KrisUnderhill/TeamSediSensor/Documentation/ESP32/pinout_devkit_v4.png

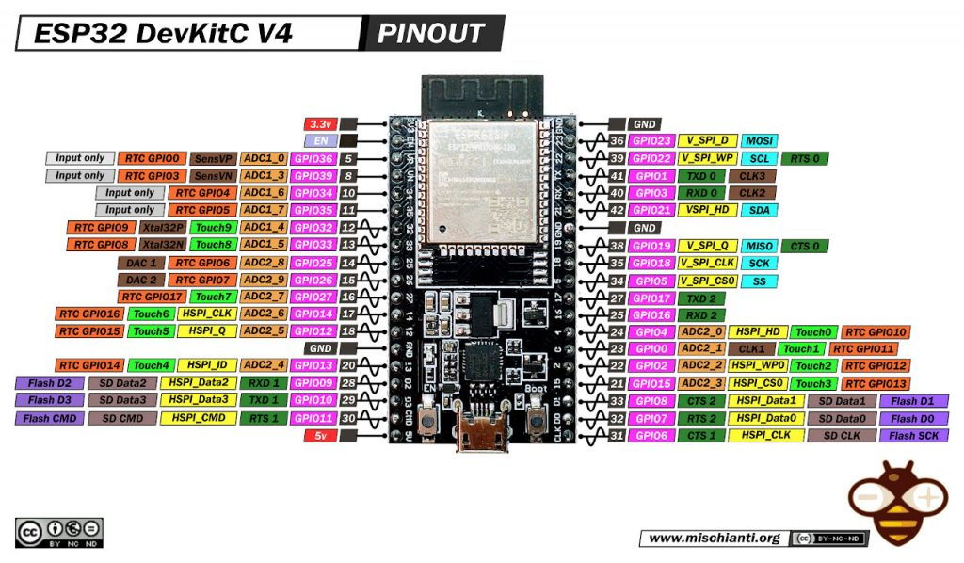
Documentation/ESP32/pinout_devkit_v4.png
