KrisUnderhill/TeamSediSensor/Documentation/BlockDiagram-Task Init.drawio.png

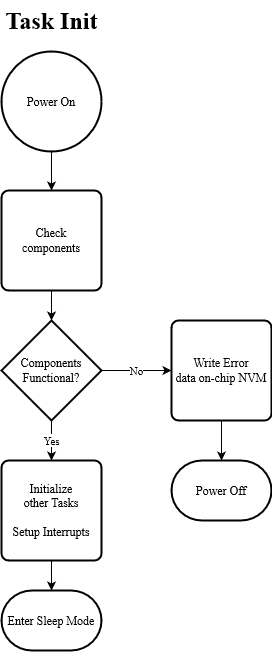
Documentation/BlockDiagram-Task Init.drawio.png
