KrisUnderhill/TeamSediSensor/Documentation/BlockDiagram-Task Transfer.drawio.png

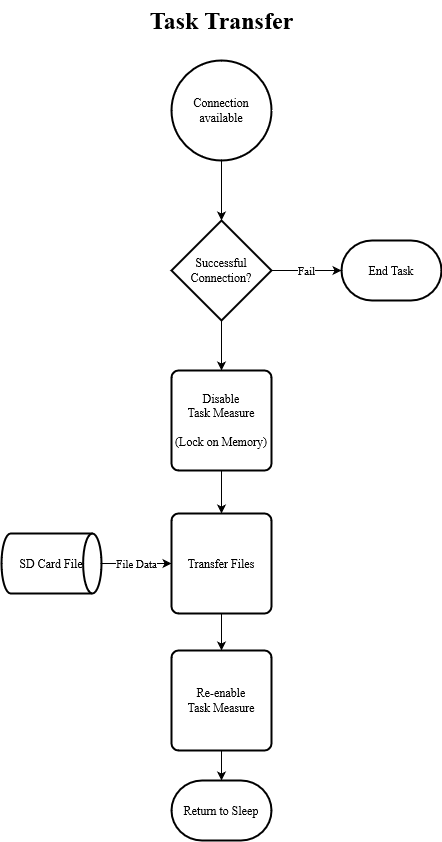
Documentation/BlockDiagram-Task Transfer.drawio.png
