KrisUnderhill/TeamSediSensor/Documentation/BlockDiagram-Task WiFi Horz.drawio.png

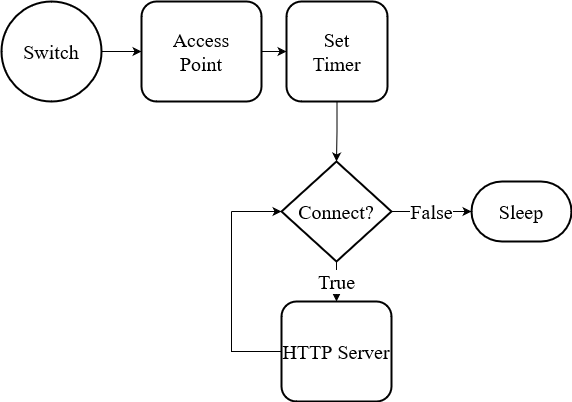
Documentation/BlockDiagram-Task WiFi Horz.drawio.png
