KrisUnderhill/TeamSediSensor/Documentation/BlockDiagram-Tasks Unified.drawio.png

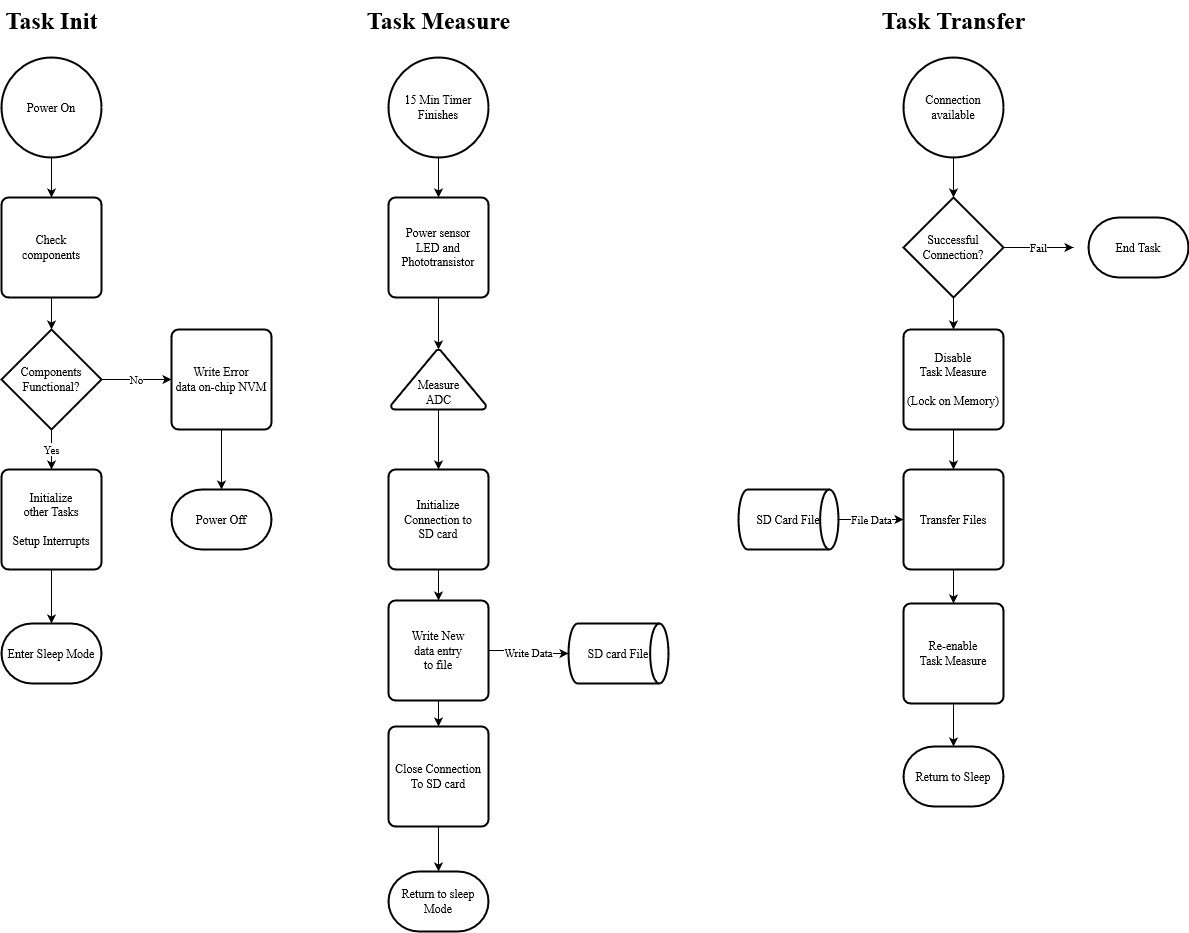
Documentation/BlockDiagram-Tasks Unified.drawio.png
