KrisUnderhill/TeamSediSensor/Documentation/Software/Fritzing_Schmatics/FinalPrototype_bb.png

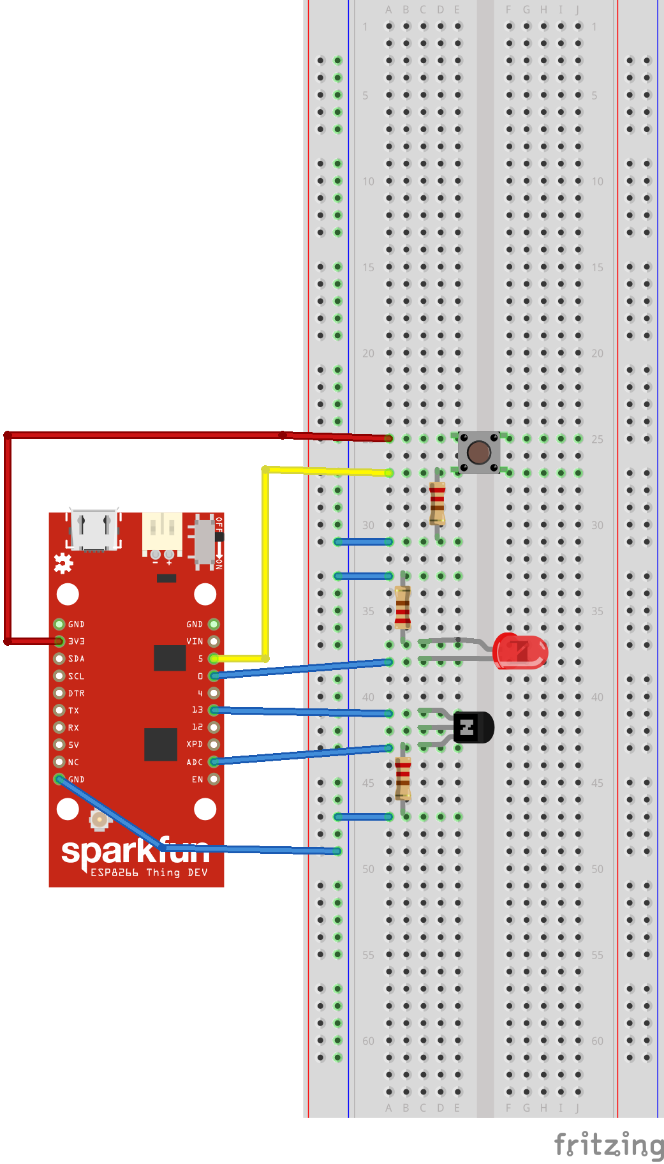
Documentation/Software/Fritzing_Schmatics/FinalPrototype_bb.png
