KrisUnderhill/TeamSediSensor/Documentation/Software/Fritzing_Schmatics/Initial_Prototype.png

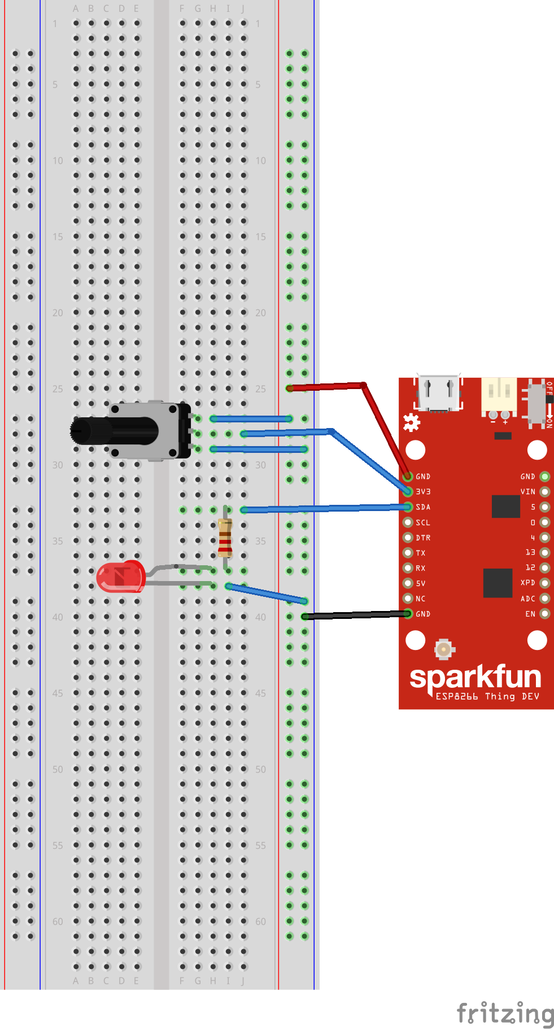
Documentation/Software/Fritzing_Schmatics/Initial_Prototype.png
