KrisUnderhill/TeamSediSensor/Documentation/Software/Fritzing_Schmatics/InitialPrototype.png

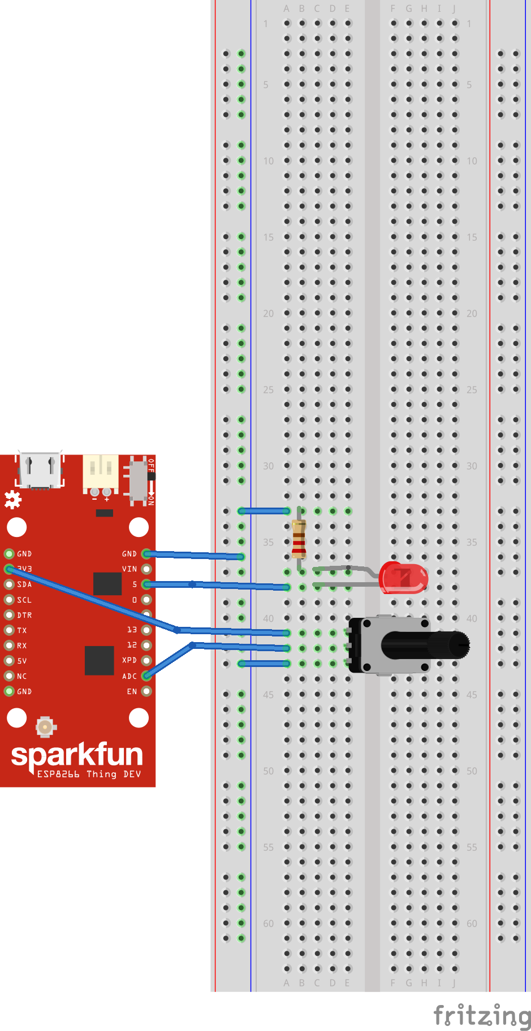
Documentation/Software/Fritzing_Schmatics/InitialPrototype.png
