KrisUnderhill/TeamSediSensor/Documentation/Software/Fritzing_Schmatics/TaskWifiPrototyp_bb.png

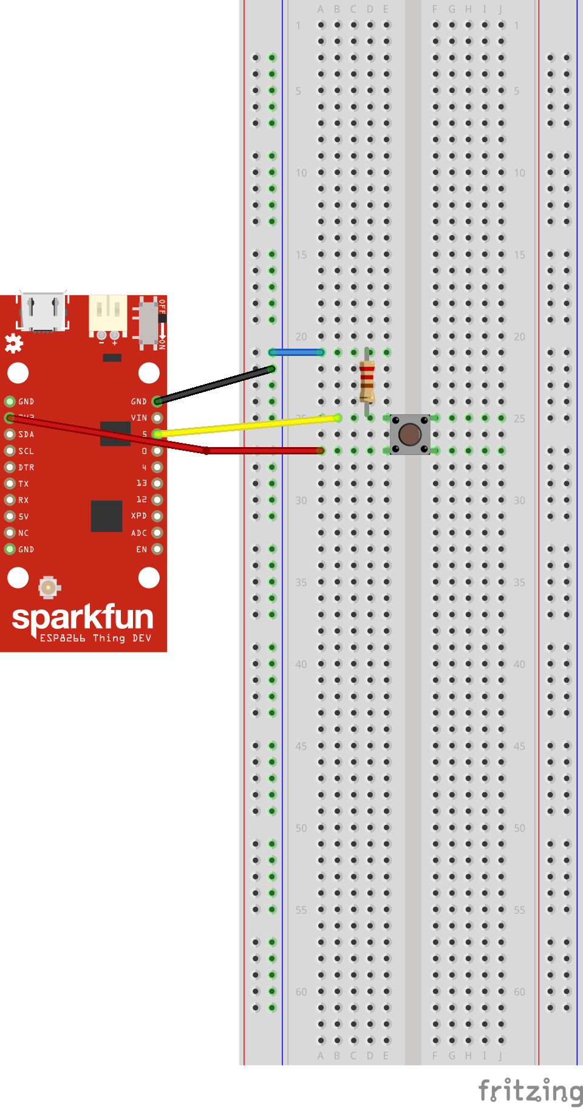
Documentation/Software/Fritzing_Schmatics/TaskWifiPrototyp_bb.png
