KrisUnderhill/TeamSediSensor/Specs/Proj_Specs_Team9.xlsx

ID | Outline | Type | Requirement | Comments | Reviewed | Next ID | 48
1 | 1 | HEADER | Sensor Design |  | TRUE
6 | 1.1 | HEADER | Accuracy |  | TRUE
17 | 1.1.1 | REQ | The sensor results shall, after calibration, match TSS data (mg/L) collected using grab sampling (traditional method) within 25% |  | TRUE
18 | 1.1.2 | REQ | The sensor results for repeated measurements on the same (Lab) sample shall match within 10% |  | TRUE
19 | 1.1.3 | REQ | The sensor results should provide a estimate for TSS data (in tons/yr) within 35% of data collected with stadia rod measurements (with estimates for soil density and characteristics and stream behavior upstream and downstream of sensor) | Prof. Wildschut measures with a different technique. Likely her method is less reliable but the measurements should line up | TRUE
7 | 1.2 | HEADER | Durability |  | TRUE
20 | 1.2.1 | REQ | The sensor should last 5 years, with regular maintenance. |  | TRUE
29 | 1.2.2 | REQ | The sensor shall perform with regular behavior for 3 months | Maintenance Interval | TRUE
30 | 1.2.3 | REQ | The sensor shall be resistant to environmental conditions |  | TRUE
31 | 1.2.4 | REQ | The sensor shall remain operable after a drop of 3 ft onto packed dirt |  | TRUE
8 | 1.3 | HEADER | Calibration |  | TRUE
21 | 1.3.1 | REQ | The sensor shall remain in calibration for 3 months. Defined as measurement after 3 months is within 10% of it’s original measurement. |  | TRUE
25 | 1.3.3 | REQ | The calibrated sensor shall have a maximum percent error of 15% |  | TRUE
22 | 1.3.4 | INFO | The sensor should be calibrated on lab samples with specified concentrations of suspended solids (Specifics of calibration procedure to be determined later) |  | TRUE
2 | 2 | HEADER | Mechanical Design |  | TRUE
9 | 2.1 | HEADER | Water Resistance |  | TRUE
23 | 2.1.1 | REQ | Sensing mechanism shall be submersible up to 5 ft of water depth |  | TRUE
26 | 2.1.2 | REQ | Sensing mechanism shall operate normally while submerged for up to 3 months |  | TRUE
32 | 2.2 | HEADER | Weather Resistant |  | TRUE
33 | 2.2.1 | REQ | The device construction should not degrade with Sunlight Exposure |  | TRUE
34 | 2.2.2 | REQ | The device shall operate during heavy rain events |  | TRUE
35 | 2.2.3 | REQ | The device shall operate regularly within the temperature range (-40°C, 85°C) |  | TRUE
36 | 2.2.4 | REQ | The device shall withstand minor snow events | Plan is for the device to be removed before/after snowfall | TRUE
10 | 2.3 | HEADER | Attachment to Streambed / Positioning |  | TRUE
27 | 2.3.1 | REQ | Device will attach to a typical rebar anchor | rebar anchor is existing infrastructure | TRUE
28 | 2.3.2 | REQ | Device attachment mechanism shall withstand flow rates of 200 cubic feet per minute |  | TRUE
45 | 2.4 | HEADER | Product Size |  | TRUE
46 | 2.4.1 | REQ | The Device shall weigh no more than 50 lbs. |  | TRUE
47 | 2.4.2 | REQ | The Device should be no larger than 2ft by 2ft by 2ft |  | TRUE
3 | 3 | HEADER | Electrical Hardware Design |  | TRUE
11 | 3.1 | HEADER | Power System |  | TRUE
37 | 3.1.1 | REQ | The device power system shall provide power for the system to operate normally for 3 months at a time without external charging |  | TRUE
38 | 3.1.2 | REQ | The system shall preserve locally stored data during a power loss event |  | TRUE
39 | 3.1.3 | REQ | The device should resume normal operation after power cycling |  | TRUE
12 | 3.2 | HEADER | Hardware Components |  | TRUE
44 | 3.2.1 | REQ | The Device shall be compliant with all FCC regulations |  | TRUE
4 | 4 | HEADER | Software Design |  | TRUE
13 | 4.1 | HEADER | Data Storage and Transmission |  | TRUE
40 | 4.1.1 | REQ | The software shall allow for intuitive and reliable access to data | *Access could mean user retrieves data in person, or data is transmitted to a server | TRUE
47 | 4.1.2 | REQ | The User should be able to see and set the device settings |  | TRUE
15 | 4.2 | HEADER | Active Behavior |  | TRUE
41 | 4.2.1 | REQ | The software shall reliably run the sensor |  | TRUE
42 | 4.2.2 | REQ | The software shall allow for reliable data collection |  | TRUE
43 | 4.2.3 | REQ | The software should recover from faults, transients |  | TRUE
