KrisUnderhill/TeamSediSensor/Software/prod/testResults/test_3_7_22.txt

Measuring with cap on about (with mirror):
2022-03-07 16:34:42, 0, 0.000, 2777, 2.645, 125, 11.9
2022-03-07 16:34:47, 0, 0.000, 2791, 2.658, 147, 14.0
2022-03-07 16:34:52, 0, 0.000, 2982, 2.840, 158, 15.0
2022-03-07 16:34:57, 0, 0.000, 1040, 0.990, 0, 0.0
2022-03-07 16:35:02, 0, 0.000, 64, 0.061, 0, 0.0
2022-03-07 16:35:07, 0, 0.000, 848, 0.808, 0, 0.0
2022-03-07 16:35:12, 0, 0.000, 1137, 1.083, 56, 5.3
2022-03-07 16:35:17, 0, 0.000, 2227, 2.121, 89, 8.5

without Mirror
2022-03-07 16:35:22, 0, 0.000, 0, 0.000, 0, 0.0

R_E transistor: 5.1K
LED current limiting: 330
