KrisUnderhill/TeamSediSensor/Software/prod/testResults/measure600mv.ods

#time | dark_ADC | dark_V | active_ADC | active_V
2022-01-31 15:18:38 | 656 | 0.529 | 654 | 0.527
2022-01-31 15:18:40 | 661 | 0.533 | 659 | 0.531
2022-01-31 15:18:42 | 664 | 0.535 | 656 | 0.529 | 630.083333333333
2022-01-31 15:18:44 | 657 | 0.529 | 643 | 0.518 | 625.5
2022-01-31 15:18:46 | 662 | 0.533 | 656 | 0.529 | 592
2022-01-31 15:18:48 | 643 | 0.518 | 656 | 0.529 | 26.4072026325621
2022-01-31 15:18:50 | 656 | 0.529 | 660 | 0.532
2022-01-31 15:18:52 | 643 | 0.518 | 647 | 0.521
2022-01-31 15:18:54 | 650 | 0.524 | 658 | 0.53 | -MEasure on the O-scope bouncing from abt 594 to 640 mv
2022-01-31 15:18:56 | 653 | 0.526 | 638 | 0.514
2022-01-31 15:18:58 | 644 | 0.519 | 654 | 0.527
2022-01-31 15:19:00 | 647 | 0.521 | 642 | 0.517
2022-01-31 15:19:02 | 637 | 0.513 | 628 | 0.506
2022-01-31 15:19:04 | 623 | 0.502 | 621 | 0.5
2022-01-31 15:19:06 | 613 | 0.494 | 624 | 0.503
2022-01-31 15:19:08 | 611 | 0.492 | 611 | 0.492
2022-01-31 15:19:10 | 614 | 0.495 | 624 | 0.503
2022-01-31 15:19:12 | 613 | 0.494 | 592 | 0.477
2022-01-31 15:19:14 | 610 | 0.492 | 607 | 0.489
2022-01-31 15:19:16 | 592 | 0.477 | 601 | 0.484
2022-01-31 15:19:18 | 597 | 0.481 | 592 | 0.477
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
