KrisUnderhill/TeamSediSensor/Software/prod/testResults/measure600mv_WithCap.ods

#time | dark_ADC | dark_V | active_ADC | active_V
2022-01-31 15:24:32 | 654 | 0.527 | 661 | 0.533
2022-01-31 15:24:34 | 642 | 0.517 | 655 | 0.528 | 638.552
2022-01-31 15:24:36 | 671 | 0.541 | 669 | 0.539 | 643
2022-01-31 15:24:38 | 672 | 0.542 | 685 | 0.552 | 624
2022-01-31 15:24:40 | 669 | 0.539 | 665 | 0.536 | 25.2508243238168
2022-01-31 15:24:42 | 663 | 0.534 | 662 | 0.533
2022-01-31 15:24:44 | 658 | 0.53 | 658 | 0.53
2022-01-31 15:24:46 | 671 | 0.541 | 673 | 0.542
2022-01-31 15:24:48 | 659 | 0.531 | 657 | 0.529
2022-01-31 15:24:50 | 650 | 0.524 | 656 | 0.529
2022-01-31 15:24:52 | 651 | 0.525 | 658 | 0.53
2022-01-31 15:24:54 | 647 | 0.521 | 649 | 0.523
2022-01-31 15:24:56 | 647 | 0.521 | 650 | 0.524
2022-01-31 15:24:58 | 643 | 0.518 | 651 | 0.525
2022-01-31 15:25:00 | 643 | 0.518 | 646 | 0.521
2022-01-31 15:25:02 | 643 | 0.518 | 638 | 0.514
2022-01-31 15:25:04 | 637 | 0.513 | 642 | 0.517
2022-01-31 15:25:06 | 640 | 0.516 | 641 | 0.517
2022-01-31 15:25:08 | 642 | 0.517 | 635 | 0.512
2022-01-31 15:25:10 | 649 | 0.523 | 638 | 0.514
2022-01-31 15:25:12 | 638 | 0.514 | 651 | 0.525
2022-01-31 15:25:14 | 645 | 0.52 | 647 | 0.521
2022-01-31 15:25:16 | 640 | 0.516 | 653 | 0.526
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
