KrisUnderhill/TeamSediSensor/Software/prod/testResults/4_6_22_afternoon_Outside.csv

#time | dark_ADC | dark_V | active_ADC | active_V | temp_ADC | temp_F | batt_ADC | batt_V | diff_ADC | diff_V
2022-04-04 18:16:47 | 9 | 0.007 | 56 | 0.045 | 784 | 63.2 | 3277 | 2.641 | 47 | 0.038
2022-04-04 18:16:48 | 4 | 0.003 | 54 | 0.044 | 784 | 63.2 | 3313 | 2.670 | 50 | 0.040
2022-04-04 18:16:49 | 203 | 0.164 | 389 | 0.313 | 784 | 63.2 | 3312 | 2.669 | 186 | 0.150
2022-04-04 18:16:50 | 177 | 0.143 | 305 | 0.246 | 782 | 63.0 | 3311 | 2.668 | 128 | 0.103
2022-04-04 18:16:51 | 150 | 0.121 | 272 | 0.219 | 782 | 63.0 | 3306 | 2.664 | 122 | 0.098
2022-04-04 18:16:52 | 208 | 0.168 | 321 | 0.259 | 783 | 63.1 | 2907 | 2.343 | 113 | 0.091
2022-04-04 18:16:53 | 49 | 0.039 | 176 | 0.142 | 780 | 62.9 | 3297 | 2.657 | 127 | 0.102
2022-04-04 18:16:54 | 55 | 0.044 | 76 | 0.061 | 782 | 63.0 | 3299 | 2.659 | 21 | 0.017
2022-04-04 18:16:55 | 0 | 0.000 | 421 | 0.339 | 784 | 63.2 | 3305 | 2.663 | 421 | 0.339
2022-04-04 18:16:56 | 0 | 0.000 | 361 | 0.291 | 784 | 63.2 | 3269 | 2.634 | 361 | 0.291
2022-04-04 18:16:57 | 75 | 0.060 | 202 | 0.163 | 783 | 63.1 | 3294 | 2.655 | 127 | 0.102
2022-04-04 18:16:58 | 85 | 0.068 | 176 | 0.142 | 782 | 63.0 | 3294 | 2.655 | 91 | 0.073
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
