KrisUnderhill/TeamSediSensor/Software/prod/testResults/SemPondTest_4_8_22.csv

#time | dark_ADC | dark_V | active_ADC | active_V | temp_ADC | temp_F | batt_ADC | batt_V | diff_ADC | diff_V | NTU
2022-04-06 16:42:54 | 0 | 0.000 | 1615 | 1.301 | 835 | 67.3 | 4095 | 3.300 | 1615 | 1.301 | 1408.190
2022-04-06 16:43:09 | 0 | 0.000 | 0 | 0.000 | 834 | 67.2 | 4095 | 3.300 | 0 | 0.000 | 34.306 | *
2022-04-06 16:43:24 | 0 | 0.000 | 0 | 0.000 | 834 | 67.2 | 4095 | 3.300 | 0 | 0.000 | 34.306 | *
2022-04-06 16:43:37 | 0 | 0.000 | 0 | 0.000 | 830 | 66.9 | 4095 | 3.300 | 0 | 0.000 | 34.306 | *
2022-04-06 16:43:52 | 0 | 0.000 | 0 | 0.000 | 829 | 66.8 | 4076 | 3.285 | 0 | 0.000 | 34.306 | *
2022-04-06 16:44:07 | 0 | 0.000 | 0 | 0.000 | 836 | 67.4 | 4084 | 3.291 | 0 | 0.000 | 34.306 | *
2022-04-06 16:44:22 | 0 | 0.000 | 0 | 0.000 | 832 | 67.0 | 4095 | 3.300 | 0 | 0.000 | 34.306 | *
2022-04-06 16:44:37 | 0 | 0.000 | 0 | 0.000 | 833 | 67.1 | 4080 | 3.288 | 0 | 0.000 | 34.306 | *
2022-04-06 16:44:52 | 0 | 0.000 | 0 | 0.000 | 833 | 67.1 | 4095 | 3.300 | 0 | 0.000 | 34.306 | *
2022-04-06 16:45:07 | 0 | 0.000 | 0 | 0.000 | 833 | 67.1 | 4052 | 3.265 | 0 | 0.000 | 34.306 | *
2022-04-06 16:45:22 | 0 | 0.000 | 0 | 0.000 | 837 | 67.5 | 4065 | 3.276 | 0 | 0.000 | 34.306 | *
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
