KrisUnderhill/TeamSediSensor/Documentation/BlockDiagram-Task Measure Horz.drawio.png

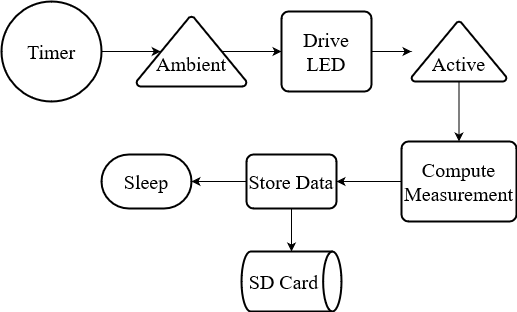
Documentation/BlockDiagram-Task Measure Horz.drawio.png
