KrisUnderhill/TeamSediSensor/Documentation/BlockDiagram-Task Measure.drawio.png

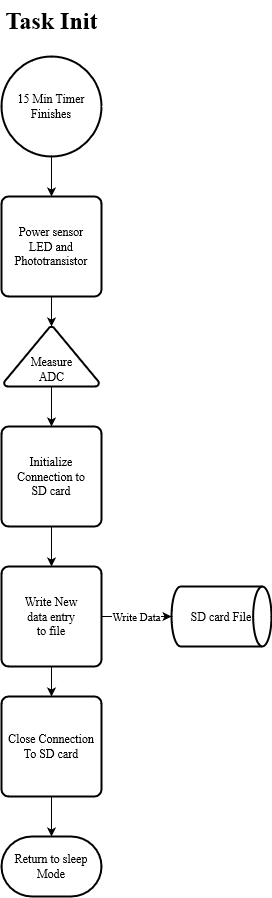
Documentation/BlockDiagram-Task Measure.drawio.png
