KrisUnderhill/TeamSediSensor/Documentation/Software/Fritzing_Schmatics/TaskMeasurePrototype.png

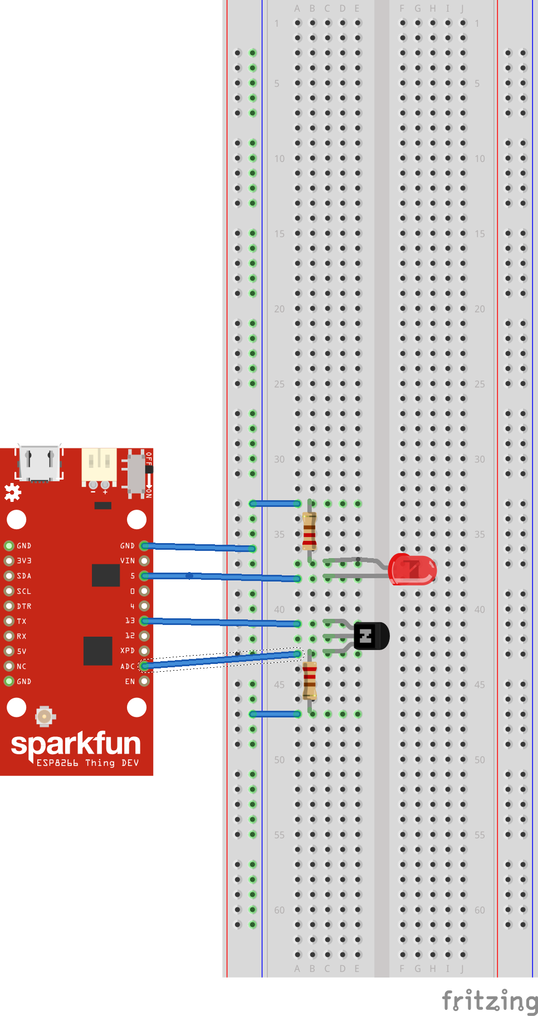
Documentation/Software/Fritzing_Schmatics/TaskMeasurePrototype.png
