KrisUnderhill/TeamSediSensor/Software/prod/testResults/WiFi_Signal_Strength_5m.png

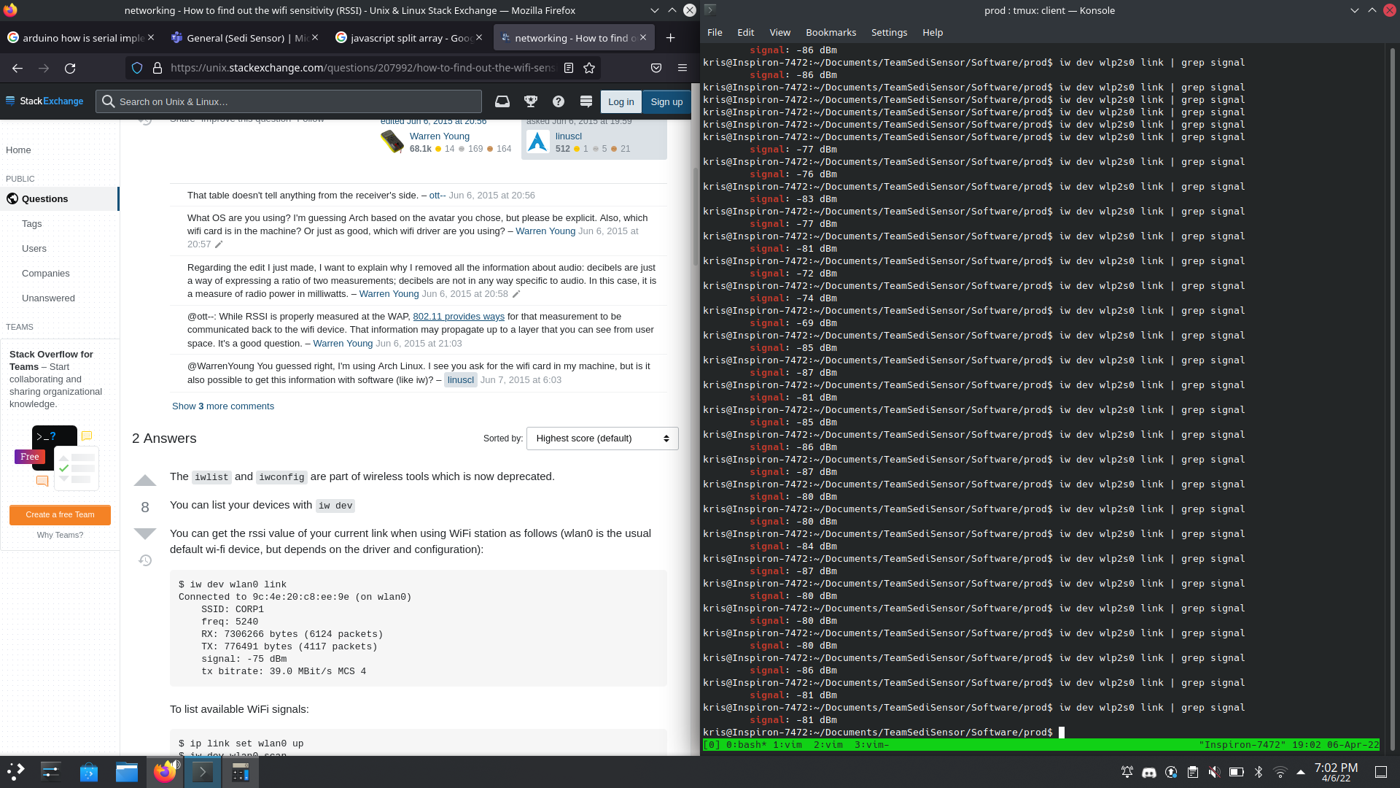
Software/prod/testResults/WiFi_Signal_Strength_5m.png
