KrisUnderhill/TeamSediSensor/(threads)

Thread 7 (2021-10-13):

Oral Presentation 2

KrisUnderhill, 2021-10-13:
### Pre-presentation
• This presentation will be to your faculty advisor and the other teams that he or she advises.
• Develop a presentation meeting the requirements below.  Your presentation should be audible,
clear, informative, and persuasive.
• The presentation complements the more-detailed PPFS and should give the advisor confidence that based on current progress, the project will finish successfully by the end of the second semester, including technical aspects along with cost and timing.
### Presentation Content
Your presentation should be approximately 10 minutes long.  Your grade may be affected if your presentation is significantly longer or shorter than that time.
Your title slide should clearly identify your team number and name and have pictures of each team member with names and concentrations.
Then reintroduce your project – briefly tell us again what problem you are trying to solve.  Most of your presentation should focus on the feasibility of your project and your status.
**Your presentation must cover:**
• What problem are you solving or what are you trying to accomplish?
• Who is/are your customer(s)?
• What are your constraints? Requirements? Objectives?
• What constitutes success at the end of the year? How will you know if you have met your goals?
• What are your design options?
• What evidence do you have to support feasibility?
• How do you evaluate your status relative to your overall timing?  **Your presentation _may_ cover:**
• What important resources have you obtained (or at least identified)?
• What engineering analysis have you done, and what did you learn from it?
• Has anything changed or is there an update on Christian motivation, virtues, or design norms?
• What major obstacles/issues have you overcome?
• What major obstacles/issues remain?
• What major decisions have you made so far? What major accomplishments can you report?
• Has anything significant changed since your first report?

Polish your presentation by making sure there are no spelling errors or grammar mistakes. Add photos of work in progress, CAD drawings, maps, mock-ups of your product, or other visuals to enhance the
presentation.

### Grading
Only one or two members of the team give the presentation, but the grade is assigned to the entire team.
An excellent presentation will:
• Stick to the time limit
• Have high-quality visual aids
• Be clear and audible
• Effectively cover the content as described above.

Thread 15 (2022-01-05):

run gpio commands based off esp32 timers

KrisUnderhill, 2022-01-05:
use timers instead of delay

KrisUnderhill, 2022-01-07:
Will need to decide how this interfaces with sleep modes, ble tasks etc.

Closed 2022-01-07.

Thread 16 (2022-01-05):

Fix Build cmd

KrisUnderhill, 2022-01-05:
Build command says bin is up to date after build command fails
fix
possiblities: base command off if binary exits not if directory is empty

KrisUnderhill, 2022-01-06:
Pt 2 find a way to only flash with app:esp32flash when build was successful

KrisUnderhill, 2022-01-06:
Fixed part 2 wont fix part 1
Reasoning: currently will have to rebuilt every time because time in config.h will have to change every build

Closed 2022-01-06.

Thread 17 (2022-01-05):

Verify cross platform compatibility for copyLib on windows

KrisUnderhill, 2022-01-05:

KrisUnderhill, 2022-03-08:
Currently can build, skips generating web files again so looking to fix that later

Thread 21 (2022-01-06):

Time Discussion

KrisUnderhill, 2022-01-06:
1) Timezones suck - discuss only using utc (Otherwise find way to generate timezone at build time)
2) Currently using build time as proxy for flash time / time after reset (ie so time will be off significantly if flashed after build or reset during operation) Otherwise find a way to reset time after the fact via BT or WIFI.
3) Abstract time into PS_Time lib

KrisUnderhill, 2022-01-13:
Decision to use Build time and expose BLE api for configuring time

Thread 23 (2022-01-06):

Fix Include paths for written libs

KrisUnderhill, 2022-01-06:
Currently include a user written lib by "../<LIB_NAME>/<FILE_NAME>.h
fix include path included automatically with "<FILE_NAME>.h"

Thread 36 (2022-01-27):

Improve HW control of sensor

KrisUnderhill, 2022-01-27:
Sensor will need to measure dark current, turn light on, measure current, calculate voltage, and turn off light

Closed 2022-01-28.

Thread 39 (2022-01-28):

Prevent multiple initializations of Singleton classes

KrisUnderhill, 2022-01-28:

KrisUnderhill, 2022-03-09:
Decided this is the job of the developer not to screw this up

Closed 2022-03-09.

Thread 46 (2022-02-09):

Power the SD Card module

KrisUnderhill, 2022-02-09:
SD Card module can now only be powered from 5v once hardware improves
power it from the 3.3 v pin

Thread 47 (2022-02-09):

Power the Temp Sensor, convert to C

KrisUnderhill, 2022-02-09:
Current temp sensor is powered from 5 volts and gives temp in F,
buy a temp sensor that can be powered from 3.3 V and gives temp in C

KrisUnderhill, 2022-03-08:
Plan is to power the temp sensor constant from 5-6.3 v, read with adc, so won't change temp sensor for now

Closed 2022-03-08.

Thread 59 (2022-02-18):

Implement FileSystem class

KrisUnderhill, 2022-02-18:
PS_SDFile doesn't work well
Need to implement class that
1) returns file ptr or class (open Method)
2) track which tasks have locks on which files
3) verify filesystem on init

Closed 2022-02-19.

Thread 60 (2022-02-18):

Debounce buttons

KrisUnderhill, 2022-02-18:
Button may currently run interrupt when not pressed bc of lacking debouncing
I don't feel like fixing this rn because as of now I have no idea what the final button looks like

Thread 68 (2022-02-20):

Decide how to measure task delays

KrisUnderhill, 2022-02-20:
1) use software/hw timer
     - possibly easier to go into light sleep during
2) Use calls to millis() and calculate against last time
      -simpler

KrisUnderhill, 2022-02-20:
#45 is similar

KrisUnderhill, 2022-03-07:
Fix #58 at the same time

KrisUnderhill, 2022-03-07:
Didn't mean to close

Thread 69 (2022-02-20):

Use a true semaphore and block when try to access locked files

KrisUnderhill, 2022-02-20:
Currently locking is supported but the calls to open() if they fail the process continues straight on
Make sure that if it continues it has the file by either blocking or looping through again to request the file

KrisUnderhill, 2022-03-07:
Not necessary until true multithreading #63

Thread 72 (2022-02-25):

Setup Watchdog Timers

KrisUnderhill, 2022-02-25:
Timers should be able to fire if wifi task or measure task fails and reset the system

Thread 78 (2022-03-09):

Bug: wifi not recognizing disconnect

KrisUnderhill, 2022-03-09:
disconnected from wifi (setup so it should shut off after so long when no devices viconnected)
When laptop disconnected from wifi it took a while for the esp to recognize that no devices were connected (like 40 sec) It just returned num connected as 0 when I had reconnected and disconnected again (the second time it worked properly)
