KrisUnderhill/TeamSediSensor/Electronics/Simulation/HighPass_RailtoRail/Draft1.asc

C1: cap; 0.15µF
C2: cap; 0.15µ
C3: cap; 0.1µ
Q2: npn
R1: res; 100k
R2: res; 10k
R3: res; 10k
R4: res; 100k
R5: res; 10k
R6: res; 10k
U1: OP07
U2: LT1490A
V1: voltage; 1v
V2: voltage; PULSE(0 100m 0 0.1n 0.1n 0.5m 1m)
V3: voltage; 3.3
Named nets: 0, Vcc
.tran 50m
