KrisUnderhill/TeamSediSensor/Electronics/Simulation/Physical_Circuit_models/Circuit_Models.asc

Q1: npn
R1: res; 91K
R2: res; 10k
R3: res; 10k
R4: res; 1k
U1: LT1001
V1: voltage; 5
V2: voltage; 5
Vsrc: voltage; 5
Vtest: voltage; 0.05
Named nets: Vcc, 0, -Vcc, Vout, Vsrc
.dc Vsrc 0 5 0.01
