KrisUnderhill/TeamSediSensor/Electronics/Simulation/ADC/test_ADC.asc

Bsclk: bv; V=max(V(sclk1),V(sclk2))
C1: cap; 10p
C2: cap; 10µ; ic=4.096; Rser=10m
C3: cap; 1n
C4: cap; 10µ; ic=1.25
D1: diode
I1: current; 2n
I2: current; 2n
Q1: npn
Q2: npn
R1: res; 330K
R2: res; 330K
U1: LTC2311-12
U2: AD8032
V1: voltage; PULSE(0 1.8 227n .1n .1n 40n 199.5n)
V2: voltage; PWL(0 0 0.1u 5)
V3: voltage; 1.8
V4: voltage; 5
V5: voltage; -5
Va-: voltage; 0
Vsclk1: voltage; PULSE(0 1.8 9.5n .1n .1n 4.65n 9.5n)
Vsclk2: voltage; PULSE(0 1.81 11.875n .1n .1n 66.5n 199.5n)
Vtest2: voltage; SINE(1 1 50k)
Vtest: voltage; 60m
Named nets: 0, OUT, sclk2, sclk1, Vcc, Vsens, Vtest, VopAmp, Vtest2, -Vcc, Vsens_base
.tran 20u
SCLK and _CNV
are shown in timing
diagram on page 11
of LTC2311-12 data sheet
Maximum admissible current draw 50 mA
Shoot for Max current of 5 mA?
ADC Circuit
Sensor Circuit
TSS
Electronics Simulation
Amplifier
