KrisUnderhill/TeamSediSensor/Electronics/Simulation/Phototransistor/test_PhotoTransistor.asc

-Vcc: voltage; 5v
Itest1: current; 20n
Q1: npn
R1: res; 330K
Vcc: voltage; 5
Vtest2: voltage; SINE(2.5 5 1k)
Vtest: voltage; 100m
Named nets: Vcc, -Vcc, 0, Vtest, Vtest2
.op
