KrisUnderhill/TeamSediSensor/Electronics/Simulation/Rail-to-Rail/test_RROpAmp.asc

-Vcc: voltage; 5v
U1: AD8031
Vcc: voltage; 5
Vtest2: voltage; SINE(2.5 5 1k)
Vtest: voltage; 100m
Named nets: Vcc, -Vcc, 0, Vtest, Vtest2, VopAmp
.tran 1m
