KrisUnderhill/TeamSediSensor/Electronics/Simulation/TransAmpedance/test_TransAmpedanceAmplifier.asc

-Vcc: voltage; 5
Itest1: current; 2n
Itest2: current; 2n
Itest3: current; 2n
Itest4: current; 2n
Q1: npn
Q2: npn
Q3: npn
Q4: npn
Q5: npn
R1: res; 1Meg
R2: res; 500k
R5: res; 330k
R6: res; 10k
U1: AD8031
U2: AD8031
U3: LT1001
V1: voltage; 0.5
V2: voltage; 4
Vcc: voltage; 5
Vtest2: voltage; SINE(2.5 5 1k)
Vtest: voltage; 100m
Named nets: Vcc, -Vcc, 0, Vtest, Vtest2, VopAmp, VopAmp2, VopAmp3
.dc Itest4 0 20n  0.01n
