KrisUnderhill/TeamSediSensor/(list of files, drawings)

Other design files:
Documentation/Software/Fritzing_Schmatics/DevelopmentPrototype.fzz
Documentation/Software/Fritzing_Schmatics/FinalPrototype.fzz
Documentation/Software/Fritzing_Schmatics/InitialPrototype.fzz
Documentation/Software/Fritzing_Schmatics/TaskWifiPrototyp.fzz
