KrisUnderhill/TeamSediSensor/(commit log)

2021-10-12 Initial writing of specs/req doc
    [Proj_Specs_Team9.csv, Proj_Specs_Team9.xlsx]
2022-01-02 Started project Rakefile
    for test_WIFIexample project
    basic functionality: build, clean
    built on top of arduino CLI calls
2022-01-06 Add Timestamp
    rakefile: autogenerates config.h lib with build time (off by about a
    minute from actual laptop time
    Task_Measure: setup time (Hardcoded Eastern), and prints
2022-01-06 app:esp32flash does not execute if build failed
2022-01-07 HW timers
    Task_Measure runs on a timer configured to trigger every 15s
2022-01-11 Started python tools
    Used for interacting with the ESP32 through linux system drivers
2022-01-13 Convert Device Discovery example into app
    Converted example software from Bluetooth into class
    same functionality
    bluetooth*.py files are straight from the examples
    will need to be changed to be made specific for our use
2022-01-13 Added class flags
    verbose allows or disables printing to screen
    re_pattern matches Addresses and Names against regex
    only outputs a match
2022-01-13 Made connection class in client_app
    supports api for connecting and disconnecting with bt devices
2022-01-13 [Broken] adding api for services
    Currently work in progress
    Will search for services/characteristics available from device
2022-01-16 Copied over to new test directory
    Especial change updated to autogenerate the service UUID
    if it stays the same linux drivers assume nothing changed about service
2022-01-19 Support filetransfer through indicates
    Refactored code controlling serv, char behaviour into PS_FileXferService
    updates to Task_BLE, and PS_FFat to support messages
    Found out needed to add all lib includes in the *.ino file
    otherwise arduino won't compile the lib
    updated rakefile to log screen output and .gitignore to ignore logs
2022-01-27 Minor Changes
    Update gitignore to ignore all files
    removed commented serial.print in PS_FFat.cpp
    tested with whole file in testFile.cpp
2022-01-28 Added prod codebase - CURRENTLY BROKEN
    copied code over from test scripts, havent cleaned up so
    functions properly
    [prod.ino]
2022-01-28 edited to provide better control over the sensor
    only controls sensor
    all new files copied from last directory test
    output dark_adc, dark_v, act_adc, act_v
2022-02-03 Record measurements from sensor ADC
    [measure600mv.csv, measure600mv.ods, measure600mv_WithCap.csv, measure600mv_WithCap.ods]
2022-02-04 Looked at specs
    [Proj_Specs_Team9.xlsx]
2022-02-05 Moved test results to folder
    [measure600mv.csv, measure600mv.ods, measure600mv_WithCap.csv, measure600mv_WithCap.ods]
2022-02-05 Added deep sleep test script
    Goal is to reduce power through deep sleep modes
    Initialized files, included arduino example scripts
2022-02-08 converted PS_FFat to PS_SDFile
    Using SD card module instead of on chip SPI flash
2022-02-09 Improve timing of measurement
    Adjusted timeouts so the electronics are appropriately powered
    when needed and measurements are accurate
2022-02-09 Finished control of the Sensor
    Temp sensor controlled
    writing to sd card
    powering sensor/led
    reading adcs
2022-02-09 Bluetooth begins advertising on button press
2022-02-11 Edited Rakefile print msg and removed readme
    Quieter output and readme no longer applied
2022-02-17 Added testing data for long test analysis
    [longTest_20K_300NTU.ods]
2022-02-18 Moved file into branch OnChipFlash
    (that was the software version that was tested
    [longTest_20K_300NTU.ods]
2022-02-18 Integrated Wifi into the codebase
    When button pressed pauses the Measure code
    starts wifi server
2022-02-19 [compiles,untested] building PS_FileSystem class
    Support switching between sd card and spi flash
    for data storage
    and locking/opening files
2022-02-20 use timers to shut off wifi
    On connect starts timer for 30 seconds. when timer fires,
    if user connected reset timer
    else timer continues
2022-02-20 Turned off timer when turn off wifi to reset later
2022-02-25 Drive LED off PWM Signal
    Using LEDC lib from ESP to drive LED on pwm signal
    Rakefile changed to use Embedded flash for memory
2022-03-05 Set PWM to 100% for now
2022-03-07 Implemented Deep sleep timing
    removed serial input option
    differentiate between wakeup sources with different init fn
    wake-up on timer or gpio (transisition high)
    calculate when next to wakeup based on rtc and when to take sensor
    measurement
2022-03-07 Run WiFi and Measure simulatiously
    protect file access and don't pause alternate task while running
    Since they run in series in the same task they don't need to protect
    variables (single threaded)
2022-03-07 Tweaks with testing
    PWM 1KHz, 330 R, 20% duty
    Always on True
    save test setup
2022-03-08 Revert to 3.3 as max voltage for ADC
    less accurate to the real voltage but makes more sense
2022-03-08 Builds on windows again
    currently can't rebuild webFiles since windows doesn't
    read throught the files or directory the same way to generate files
    but otherwise can build normally
    Looking to change the generation to a RAWDATA type for working in
    c++
2022-03-08 Transfer working file to other device
2022-03-08 made changes to file, need to it back on other device
    Can't connect to api since not same origin
    so must be served by the server for proper function
2022-03-09 Improve download "button" to look like button
2022-03-09 Converted method for measuring delays
    Using state machine for task
    Measuring delays by millis() tracking when to enter next
    state
2022-03-09 Added Test data and changed comments
    [test_3_9_22_AmbOutside.csv]
2022-03-12 Removed old testing folder paths
    moved some test data to prod/testResults
    [measure600mv.csv, measure600mv.ods, measure600mv_WithCap.csv, measure600mv_WithCap.ods, test_3_9_22_AmbOutside.csv]
2022-03-12 Remove unused keywords.txt
    Supposed to be used for Arduino IDE but Since I
    don't use that I'm not supporting that
2022-03-28 Added incremental fritzing diagrams
    [DevelopmentPrototype.fzz, FinalPrototype.fzz, InitialPrototype.fzz, TaskWifiPrototyp.fzz]
2022-03-29 OTA update supported, measure battery pin
2022-04-06 Debounce Switch to turn on wifi
    Switch must be on again after 100ms to actually init wifi
2022-04-06 Add NTU Calibration
2022-04-06 Configuration and test results
    4_5_22 overnight test
    [overNightTest_4_5_22.csv]
2022-04-06 Move MOSI SPI pin
    MOSI Pin connected to the sd card module broke
    replace with pin 17
    Squashed commit of the following:
    commit 9bf76db88ae932b0a48398edf3b7bb95fb3b89fc
    Author: Kris <kristophermiedema@gmail.com>
    Date: Wed Apr 6 13:33:28 2022 -0400
    Modified rakefile to use changes to SD lib
    commit 92caf346553f56a1979ca40f871ce384788fb569
    Author: Kris <kristophermiedema@gmail.com>
    Date: Wed Apr 6 13:32:01 2022 -0400
    modify code base to use project specific SD lib
    and custom pins
    commit debb6b6298be4ad39c70bedf956b3b00949d7f08
    Author: Kris <kristophermiedema@gmail.com>
    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
    [prod.ino]
2022-04-07 Added testing results
    [4_6_22_afternoon.csv, 4_6_22_afternoon_Outside.csv, 4_6_22_afternoon_Outside_SD.csv]
2022-04-09 File from testing on sem pond
    [SemPondTest_4_8_22.csv]
